trooper7652-commits/RocketFC/README.md

# RocketFC — TVC Self-Landing Model Rocket Flight Computer



Google drive link with numerous photos of this model rocket project (and a few of my other projects): https://drive.google.com/drive/folders/1t4HR8e49pa-YUd3eFnzsIMzDf4J9D1U2?usp=sharing

A complete flight computer for a thrust-vector-controlled (TVC), propulsively
landed model rocket, built for the **Teensy 4.1** with a **BMI088**
accelerometer/gyro and a **GY-63 (MS5611)** barometer.

- 2-axis servo-gimbal TVC with per-axis PID and correct roll decoupling
- Quaternion attitude estimation (gyro-integrated, accel level-init on the pad)
- 3-state Kalman filter (altitude, vertical velocity, accel bias) fusing
  barometer + accelerometer
- Full flight state machine with debounced transitions, backup timers, and
  layered aborts
- Landing-burn ignition timed by a precomputed `h_ignite(velocity)` table
  generated from the Estes F15 thrust curve
- Spring-ejected parachute on a servo latch, with accelerometer
  confirmation and automatic re-cycling of a stuck latch
- Two pyro channels with continuity sensing and multiple safety
  interlocks: landing-motor igniter, and a nichrome landing-leg release that
  burns from 1 s into a confirmed landing burn until touchdown
- 100 Hz CSV logging to the built-in microSD, USB-serial CLI, buzzer/LED
  status, EEPROM-persisted settings, hardware watchdog
- A PC replay harness that compiles the *exact* flight code and tests it
  against synthetic flights — no hardware needed

```
RocketFC.ino          hardware glue: polling scheduler (500/100/50/10 Hz)
src/config.h          every pin, gain, mass, and threshold — start here
src/core/             flight LOGIC, pure C++, shared with the PC test harness
  quat.h              vector/quaternion math
  ahrs.h              attitude estimation
  altitude_kf.h       altitude/velocity Kalman filter
  control.h           TVC PID
  flight_state.h      state machine + aborts
  chute_deploy.h      parachute release: canopy confirm + latch re-cycle
  burn_table.h        GENERATED — landing-burn ignition table
  flight_core.h       wires the above together (single entry point)
src/hw/               Teensy-only drivers: sensors, actuators, logger, CLI...
tools/
  burn_table.py       F15 thrust curve -> burn_table.h  (rerun after measuring!)
  synth_flight.py     generates synthetic test flights
  replay/             PC test harness (g++/MSYS2): make test
  plot_flight.py      post-flight log plots (matplotlib)
```

The rest of the project lives beside the firmware:

```
CAD/                  Autodesk Inventor parts (.ipt) and assemblies (.iam);
                      SpaceX Assembly.iam is the whole rocket
  exports/            STEP / STL exports
  Avionics Holder/    FEA (stress analysis) data for the avionics holder
Electronics/          KiCad schematic/PCB and the wiring diagram
ThrustStand/          HX711 static thrust stand (measures ignition delay, thrust curves)
SensorServoBenchTest/ bench rig that checks IMU axes and servo signs on real hardware
tools/sim/            closed-loop simulator + flight-log dashboard
tools/hil/            hardware-in-the-loop static-fire tooling
tools/tvc-sim/        standalone TVC PID auto-tuner
studies/              simulator design studies (landing timing, motors, parachute size)
docs/research/        research notes (other propulsive-landing projects, solver notes)
```

---

## 1. Hardware & wiring

| Signal | Teensy 4.1 pin | Notes |
|---|---|---|
| Gimbal servo A (body X torque) | 2 | PWM, 50 Hz |
| Gimbal servo B (body Y torque) | 3 | PWM, 50 Hz |
| Parachute latch servo | 23 | PWM, 50 Hz; holds the spring-ejection latch |
| Pyro fire — landing motor | 6 | MOSFET gate, low-side driver |
| Pyro fire — leg-release nichrome | 7 | MOSFET gate, low-side driver |
| Continuity sense — landing | 14 (A0) | 100k/10k divider from the landing MOSFET drain |
| Continuity sense — legs | 15 (A1) | 100k/10k divider from the legs MOSFET drain |
| Battery voltage | 16 (A2) | divider, ratio in `VBAT_DIVIDER` |
| Buzzer | 8 | active buzzer or transistor-driven |
| Arm switch | 9 | **not fitted** — pin unused, `REQUIRE_ARM_SWITCH = false` |

Power: a 2S LiPo for the flight computer and servos, and a **separate 2S
pyro LiPo** for both pyro channels. Tie the pyro LiPo's − to Teensy GND
(never the +): the MOSFET gates and the continuity dividers need the common
ground. With a load connected, each drain sits at pyro battery voltage, so
the dividers also read the pyro battery (`pyro:` in `status`).
| BMI088 + MS5611 | 18 (SDA), 19 (SCL) | I2C, 400 kHz, 3.3 V |
| LED | 13 | built-in |

Hardware rules that save rockets:

- **Teensy 4.1 is 3.3 V and NOT 5 V tolerant.** Never feed 5 V servo signals
  or sensor boards with 5 V pull-ups into its pins.
- **Servos get their own BEC/regulator**, never the Teensy's 3.3 V rail. A
  servo stall browning out the flight computer mid-burn = lost rocket.
  Common ground between BEC, battery, and Teensy.
- Parachute latch: design it so the spring **cannot back-drive the servo**
  (e.g. a pin loaded across its axis, not along it). Before the firmware
  starts, the servo gets no signal; a latch that slips when the servo goes
  limp ejects the chute on the pad. Once running, the firmware puts the
  latch back at the **last position commanded on the ground** (saved in
  EEPROM, `CHUTE_BOOT_RESTORE`), so a locked latch stays locked across a
  power-cycle. It boots **open** instead after a watchdog/crash reset, or if
  the IMU sees the vehicle moving or away from ~1 g at power-up (a power blip
  in flight). Trade-off: a power loss in flight while the rocket reads a
  steady ~1 g reboots into IDLE with the chute held in; set
  `CHUTE_BOOT_RESTORE = false` to always boot open. The servo has no memory
  of its own — unplugged it stays roughly put but doesn't hold against the
  spring. The chute servo shares
  the gimbal servos' BEC — check the rail with all three moving at once.
- Pyro channels: logic-level MOSFETs, low-side, **gate pulldown resistors**
  (so a floating pin during boot can't fire), and flyback-safe wiring.
  There is **no arm switch**: the pyro LiPo connector is the arm. The pyros
  are live whenever it is plugged in, so plug it in last, on the pad.
- Leg-release nichrome: it is on for **~3–4 s** (fire + 1 s → touchdown
  detected), drawing amps the whole time, overlapping the e-match gate by
  0.2 s and the TVC servos' hardest work. Power it from the **pyro battery**,
  never the flight computer's, through a MOSFET rated for that current.
  Touchdown is only declared after 0.8 s of stillness, so the wire keeps
  glowing ~1 s on the ground — keep it clear of anything flammable.
- Mount the IMU rigidly, close to the CG, axes square to the airframe. Set
  `IMU_R_SB` in `config.h` to match the mounting orientation.
- Barometer: open-cell foam over the MS5611 port, in a vented bay, shielded
  from sunlight (it is light-sensitive) and from ram/exhaust airflow.
- Use fast metal-gear micro servos (speed matters more than torque for TVC),
  and landing legs with some compliance — expect 1–3 m/s residual touchdown
  velocity even with perfect timing.

## 2. Toolchain setup

**Arduino IDE 2.x** (for uploading):
1. Install Arduino IDE 2.x.
2. File → Preferences → *Additional boards manager URLs*, add:
   `https://www.pjrc.com/teensy/package_teensy_index.json`
3. Boards Manager → install **Teensy**.
4. Library Manager → install **Bolder Flight Systems BMI088**.
5. Open `RocketFC.ino`, select **Teensy 4.1**, Verify/Upload.

Servo, SD/SdFat, EEPROM, and Wire ship with the Teensy core. The MS5611
driver is written in-project (`src/hw/sensors.h`) — no library needed.

**Command line** (what was used to develop this):

```
arduino-cli compile --fqbn teensy:avr:teensy41 RocketFC
```

**PC test harness** (needs g++ and Python 3):

```
cd tools/replay
make test        # regenerates synthetic flights and runs all assertions
```

## 3. Before you fly anything: measure and replace placeholders

Everything marked `[MEASURE]` in `src/config.h` is a placeholder. The
important ones:

| Parameter | How to measure |
|---|---|
| `MASS_PAD_KG`, `MASS_DESCENT_KG` | kitchen scale, fully loaded / after ascent burnout |
| `ASCENT_BURN_MS` | your ascent motor's datasheet or static test |
| `IGNITION_DELAY_MS` | **static-test the F15 igniter chain**: time from fire command to first thrust. This number directly moves the ignition altitude. |
| `CDA_M2` | estimate from a drop test or flight log velocity decay |
| Servo trims, `US_PER_GIMBAL_DEG`, signs | bench: CLI `trim`, `servotest`, direction test below |
| chute LOCK / OPEN angles | bench: CLI `chute deg <n>` until the latch is fully closed / fully open, then `chute set lock` / `chute set open` (saved in EEPROM; `CHUTE_*_DEG_DEFAULT` are only first-boot defaults) |
| `CHUTE_SERVO_US_AT_0_DEG`, `_AT_180_DEG` | servo datasheet: pulse width at 0° and 180° (default 500 / 2500 µs) |
| `CHUTE_RECYCLE_LOCK_MS` | bench: time the servo takes to swing release → lock (`chute cycle`) |
| Leg release timing | bench: `pyrotest legs`, time until the band parts; put it in the sim's "Legs: band cut" field and check the margin (see §4) |
| `VBAT_DIVIDER` | multimeter vs. `status` readout (`CONT_DIVIDER_RATIO` is set from the 100k/10k schematic; check `pyro:` against a meter) |

Then regenerate the burn table with your measured values:

```
python tools/burn_table.py     # rewrites src/core/burn_table.h
cd tools/replay && make test   # confirm the logic still passes
```

**Servo direction test (do this or the rocket flies into the ground):**
power up on the bench, run `cal`, then tilt the nose toward body +X.
The gimbal must deflect so the *thrust vector pushes the tail back under
the nose* (i.e. it fights the tilt, not amplifies it). If a channel moves
the wrong way, flip `SERVO_A_SIGN`/`SERVO_B_SIGN`. Repeat for +Y.

## 4. Flight states

```
IDLE -> ARMED -> BOOST -> COAST -> APOGEE -+-> DESCENT -> LANDING_BURN -> TOUCHDOWN
                                           |   (FULL_LANDING mode)
                                           +-> DESCENT_CHUTE -> TOUCHDOWN
                                               (CHUTE_TEST mode, or any abort)
```

- **ARMED**: gyro/level/baro calibrated, log open, launch detection live
  (>1.5 g longitudinal for 80 ms).
- **BOOST**: TVC active with boost gains. Burnout on <0.35 g for 150 ms,
  backed up by a max-burn timer.
- **COAST**: servos centered. Apogee on KF velocity ≤ 0 (200 ms), backed up
  by altitude-drop and absolute timers.
- **DESCENT**: fires the landing motor when KF altitude falls to
  `h_ignite(descent rate)` from the burn table — but only if tilt < 15°,
  the KF is healthy, and igniter continuity is present.
- **LANDING_BURN**: TVC active with landing gains. Confirms ignition by the
  accel jump; a dud igniter aborts to chute. No aborts once burning — TVC
  rides it out. `LEGS_DELAY_MS` (1 s) after the fire command — and only into
  a confirmed burn — the leg-release nichrome comes on and stays on until
  touchdown is detected (`LEGS_BURN_MAX_MS` is an independent cutoff). The
  legs never deploy in CHUTE_TEST or after an abort. **Timing is tight:** in
  the closed-loop sim the vehicle reaches the ground ~2.9 s after the fire
  command, leaving ~1.9 s for the band to part and the legs to swing down.
- **ABORT** (tilt > 30°, IMU failure, KF unhealthy, missed window, dud):
  permanently inhibits the landing motor and releases the chute (waiting for
  motor burnout if aborting during BOOST).

**Parachute release** (`src/core/chute_deploy.h`): the chute is pushed out by
a spring; the servo on pin 23 holds the latch. On release, the flight
computer watches the accelerometer for the canopy (≈0 g in freefall, ≈1 g
plus an opening spike under a canopy). If nothing shows within
`CHUTE_CONFIRM_MS` (1.5 s), it swings the latch back to LOCK for
`CHUTE_RECYCLE_LOCK_MS` and releases again — up to `CHUTE_MAX_RELEASES` in
total — then holds it open for good. Re-cycling a latch whose chute is
already out is harmless, so the detector errs on the strict side; a canopy
that opens near apogee (no airspeed yet) can show up late and cost one
needless re-cycle. Jolts below `TOUCHDOWN_ALT_M` never count, so a crash is
never logged as a good chute. Events in the log: `CHUTE_RELEASE` (every
release), `CHUTE_DETECTED`, `CHUTE_UNCONFIRMED`; the `pyro` column's bit 0 is
the latch position and the `cont` column's bit 0 is "canopy detected".
Each re-cycle costs ~2 s of fall, so on a low flight there is only time
for one or two.

**Modes** (`mode chute` / `mode land`, persisted in EEPROM):
`CHUTE_TEST` flies the full TVC ascent and pops the chute at apogee —
this is how you validate everything before risking a landing attempt.
`FULL_LANDING` attempts the propulsive landing; the chute is released only
as the abort recovery.

## 5. CLI (USB serial, 115200)

| Command | Action |
|---|---|
| `help` / `status` | command list / one-shot health & sensor readout |
| `stream` | toggle 10 Hz live telemetry |
| `cal` | gyro bias + level calibration (keep still ~4 s) |
| `zero` | baro ground reference + noise measurement |
| `arm` / `disarm` | pre-arm checks, then ARMED (launch detect live!) |
| `mode chute` / `mode land` | select flight mode (persisted) |
| `trim a +20` / `center` | servo trim (persisted) / center servos |
| `servotest` | slow gimbal sweep for the direction test |
| `circle [s] [deg]` / `circle off` | gimbal runs in circles until turned off — default 1 s/rev at full deflection; disarmed only, `center`/`stop` also end it, `cal`/`zero`/`arm` refused while circling |
| `chute` | show the parachute latch position |
| `chute open` / `chute lock` | open the latch to load the spring / lock it (arming is refused until locked) |
| `chute deg <n>` / `chute us <n>` | jog the latch servo to an angle (0–180°) or a pulse width |
| `chute set lock [deg]` / `chute set open [deg]` | save the LOCK / OPEN angle to EEPROM (default: the current jog angle); the servo only moves if it's already at that position |
| `chute defaults` | LOCK / OPEN angles back to the `config.h` defaults |
| `chute cycle` | one in-flight re-cycle: LOCK dwell, then RELEASE — tests freeing a sticky latch |
| `pyrotest land` | fire the landing e-match channel on the bench — two-step typed confirmation, disarmed only, **no motor/match connected** |
| `pyrotest legs` | burn the leg-release nichrome for 4 s (its longest in-flight burn) — two-step confirmation, disarmed only |
| `stop` | every pyro output off immediately |

## 6. Beeps & LED

| Pattern | Meaning |
|---|---|
| Boot chirp | power-on |
| Slow single blink/beep | IDLE, healthy |
| Repeating N beeps in IDLE | fault: 1=IMU 2=baro 3=SD 4=battery |
| 2 beeps repeating | ARMED, CHUTE_TEST mode |
| 3 beeps repeating | ARMED, FULL_LANDING mode |
| Silence | in flight (nothing to say, everything logged) |
| Loud repeating chirp | TOUCHDOWN — locate beacon |

## 7. Launch-day checklist

1. Fresh battery; `status` shows vbat > `VBAT_MIN`.
2. SD card inserted; `status` shows SD OK.
3. `mode` set correctly (listen for the 2-vs-3-beep pattern at arm).
4. Load the chute: `chute open` (the latch boots wherever it was last left), spring + chute
   in, `chute lock`. Strap the
   legs with a fresh band over the nichrome. Then rig motors + e-match
   **last**, on the pad, with the pyro LiPo **unplugged**.
5. Vehicle vertical on the rail, still. Plug in the pyro LiPo; `status`
   should show `pyro:` ≥ 7.0 V and continuity `landing=YES legs=YES`.
   Then `arm` from the laptop (the only way to arm). Pre-arm checks verify
   sensors, SD, battery, chute latch locked, landing e-match and legs
   nichrome continuity plus pyro battery ≥ `PYRO_VBAT_MIN` (FULL_LANDING),
   and tilt < 5°.
6. Clear the area. Launch when ready — everything from here is autonomous.
7. After recovery: `flight_NNN.csv` from the SD card →
   `python tools/plot_flight.py flight_NNN.csv` and review before any tuning.

## 8. Tuning guide

- **PID (`GAINS_BOOST`, `GAINS_LANDING`)**: start on a static test stand or
  a tethered/gimbaled mount. Raise `kp` until the response is crisp but not
  oscillating, add `kd` to damp, keep `ki` small (it exists to trim steady
  thrust misalignment). The landing gains act on a lighter vehicle —
  expect them ~30% hotter. Replay real flight logs through `tools/replay`
  to sanity-check changes before flying them.
- **Kalman filter**: `R` is measured from pad noise automatically at arm.
  `KF_SIGMA_ACCEL` is the knob: bigger = trust the baro more (noisier but
  no drift), smaller = trust the accel more (smoother but drifts).
  The logged `innov` column should look like zero-mean noise; sustained
  offsets mean the filter is mistuned.
- **Burn table margin**: after a landing attempt, compare the logged
  ignition altitude/velocity against the table's prediction and adjust
  `BURN_TABLE_MARGIN_M` (positive = ignite higher/earlier).

## 9. Reality check: what dominates landing success

The F15 is a fixed-impulse solid motor — it cannot throttle. The physics
(from `tools/burn_table.py` with a 0.95 kg descent mass):

- Only apogees roughly **15–80 m** arrive at the ignition window with an
  energy the F15 can cancel. Size the ascent motor accordingly.
- **Ascent motor: AeroTech F10** (29 mm single-use, 7 s burn, flown *plugged*,
  `tools/motors/AeroTech_F10.eng`). Its ~73 m apogee matches the F15's energy,
  and because it pushes almost all the way to apogee the fin-less airframe
  never coasts long enough to tip over in wind. The closed-loop sim study
  (2026-10-24) found short, hard-burning motors abort 94–100 % of flights.
- **±10% motor-to-motor thrust variation → ~9–15 m/s touchdown error** if
  uncompensated. This — not the software — is the hard part. Mitigate with:
  legs that absorb residual velocity, fresh motors from the same pack,
  static-tested ignition delay, and iterating on logged flights.
- ±150 ms of unmeasured ignition delay costs similar error. Measure it;
  don't guess it.

Fly the incremental program: **bench tests → static TVC stand → CHUTE_TEST
flights (validate AHRS/KF/TVC/logging) → landing attempts**, reviewing the
log after every single flight.

## 10. Safety & legal

E-matches and rocket motors are energetic devices. Never work on the pad
with the pyro battery connected; keep the pyro LiPo unplugged until the
vehicle is on the pad. Propulsive-landing TVC flights generally fall **outside**
NAR/TRA club safety codes — fly under FAA Part 101 hobby rules on private
land with generous clear distances, or coordinate explicitly with your club.
You are responsible for complying with your local regulations.

---

*Built with Claude Code. The core flight logic in `src/core/` is verified by
`tools/replay` (unit checks + 6 synthetic flight scenarios) on every change:
`cd tools/replay && make test`.*

# Why I made this project
I wanted to get my hands dirty with an advanced project so that I would force myself to learn new software and hardware skills that will be useful to me for later projects. I chose to build an autonomously landing model rocket because I was inspired by SpaceX landing their Starship. Additionally, I knew about thrust vector control in planes and fighter jets before, but I became really interested in it after I found out that they were also used in rockets as well.
