trooper7652-commits/RocketFC/studies/landing-solver-study/notes/plots/clean_apogee_sweep_all.png

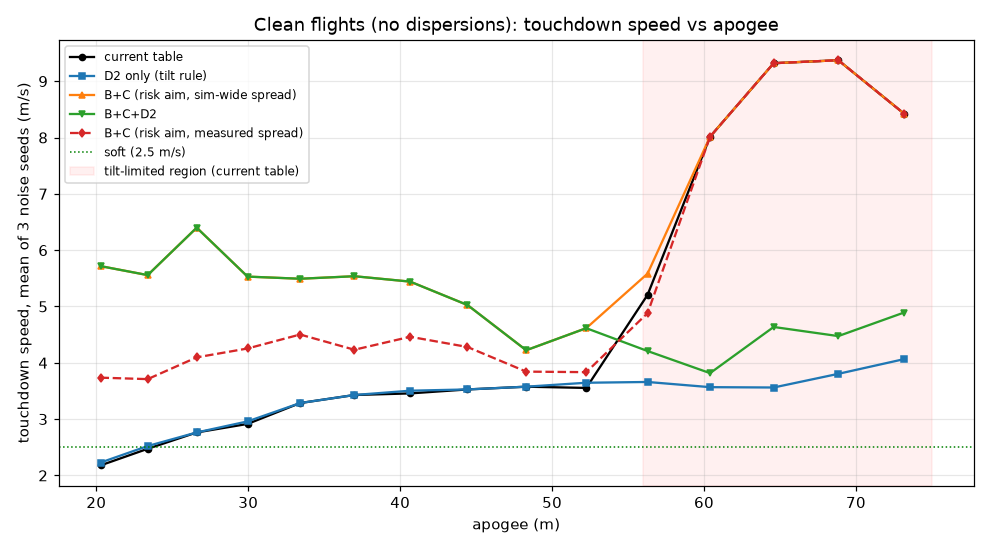
studies/landing-solver-study/notes/plots/clean_apogee_sweep_all.png
