trooper7652-commits/RocketFC/studies/landing-solver-study/notes/plots/headroom_examples.png

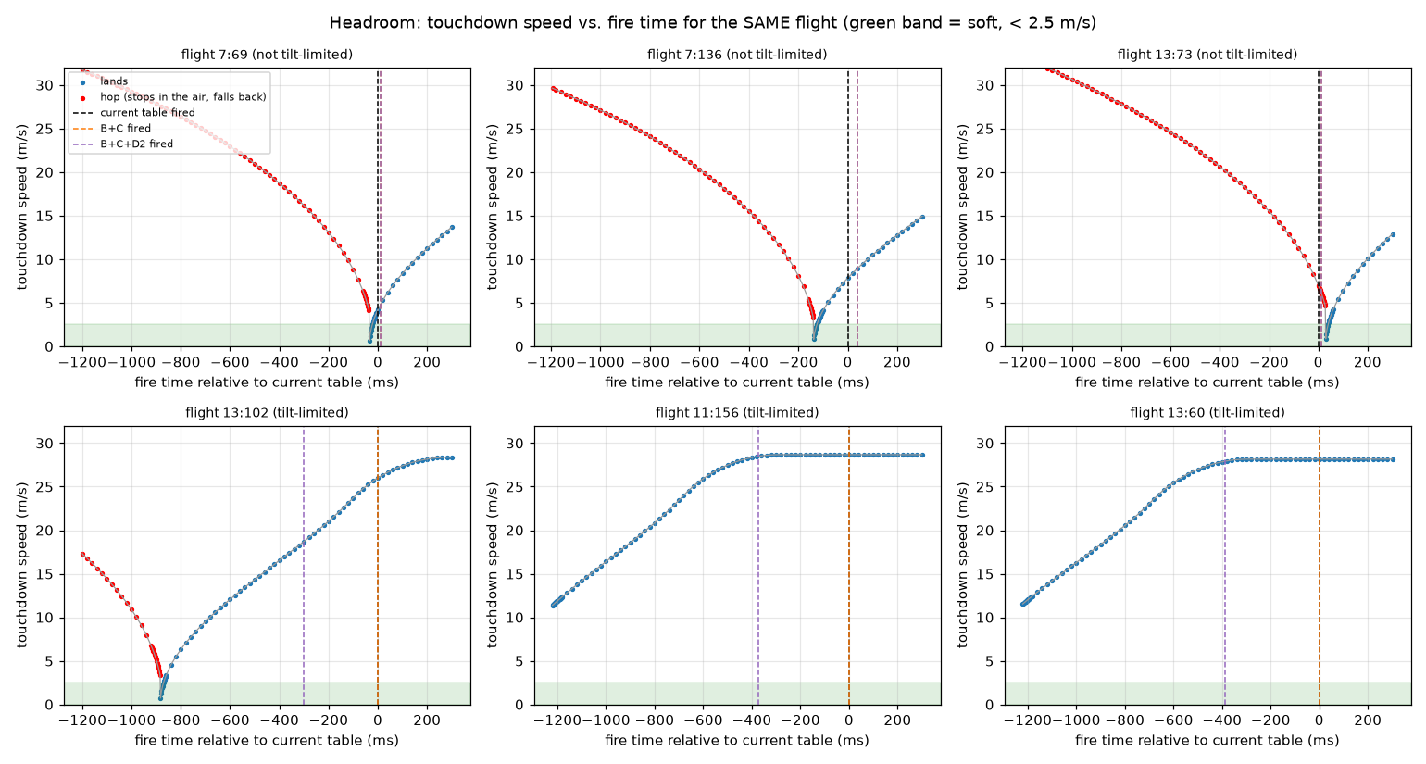
studies/landing-solver-study/notes/plots/headroom_examples.png
