trooper7652-commits/RocketFC/studies/landing-solver-study/notes/plots/holdout_cdf.png

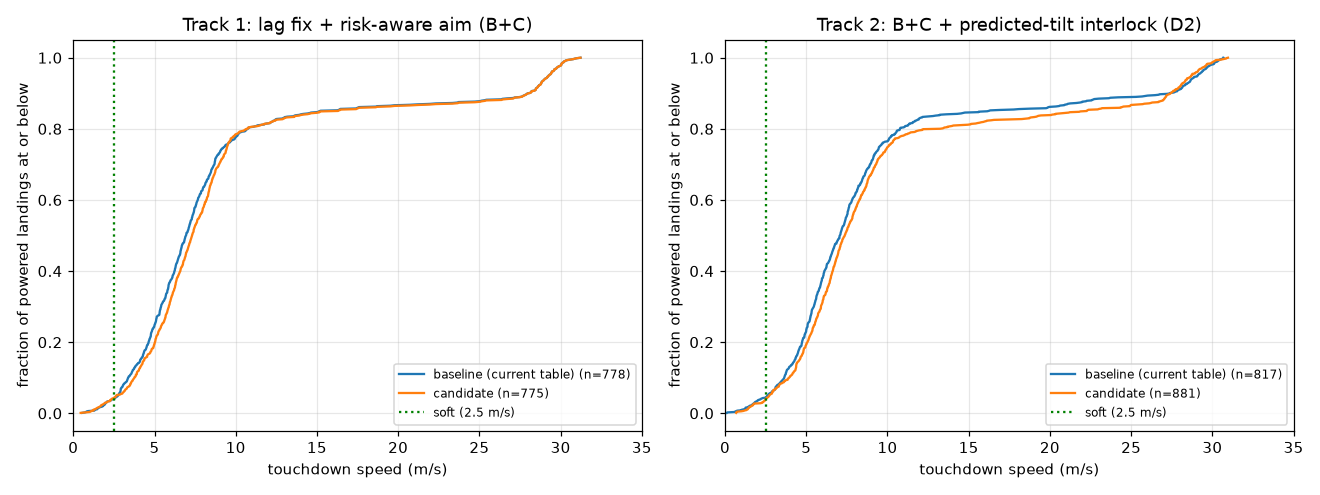
studies/landing-solver-study/notes/plots/holdout_cdf.png
