trooper7652-commits/RocketFC/studies/landing-solver-study/notes/plots/holdout_paired_scatter.png

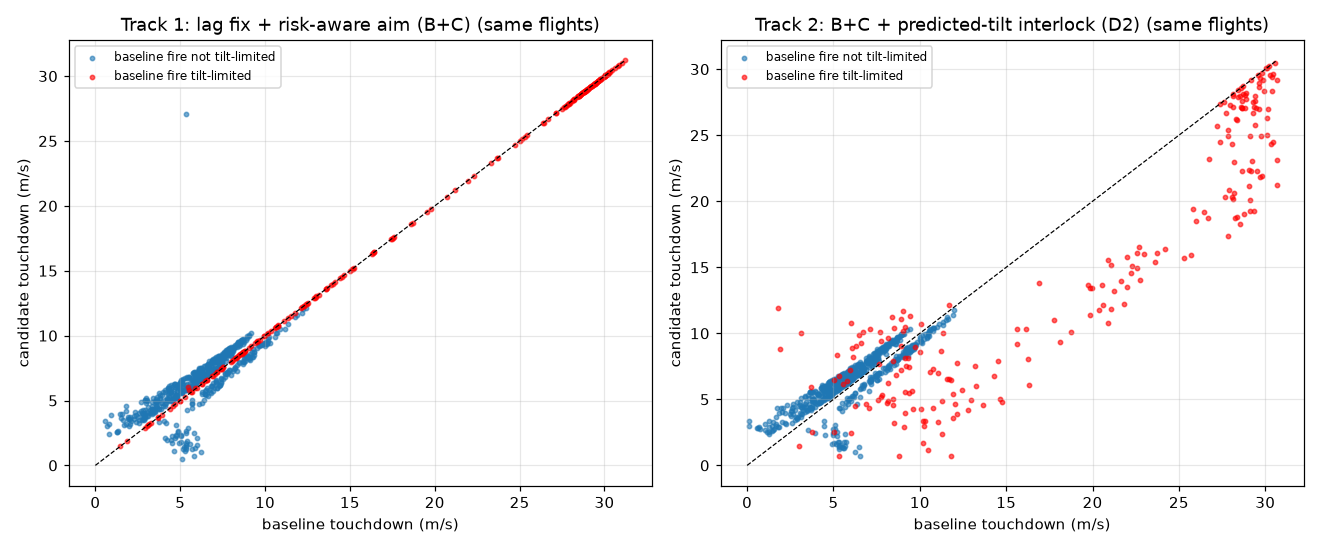
studies/landing-solver-study/notes/plots/holdout_paired_scatter.png
