trooper7652-commits/RocketFC/studies/landing-solver-study/notes/plots/p0_kf_lag_and_tilt.png

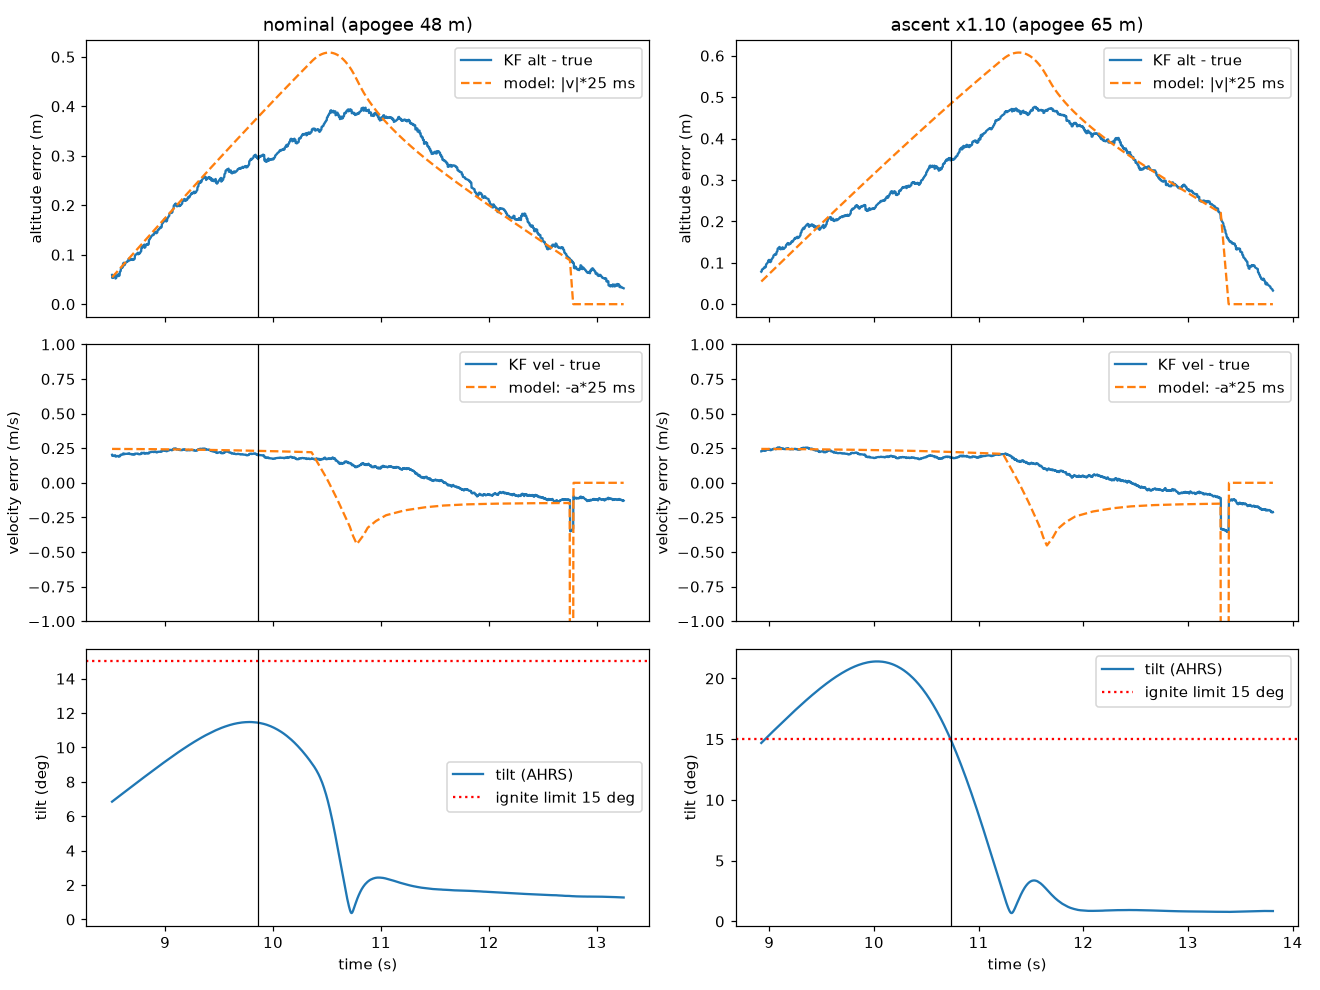
studies/landing-solver-study/notes/plots/p0_kf_lag_and_tilt.png
