trooper7652-commits/RocketFC/studies/landing-solver-study/notes/plots/value_of_information.png

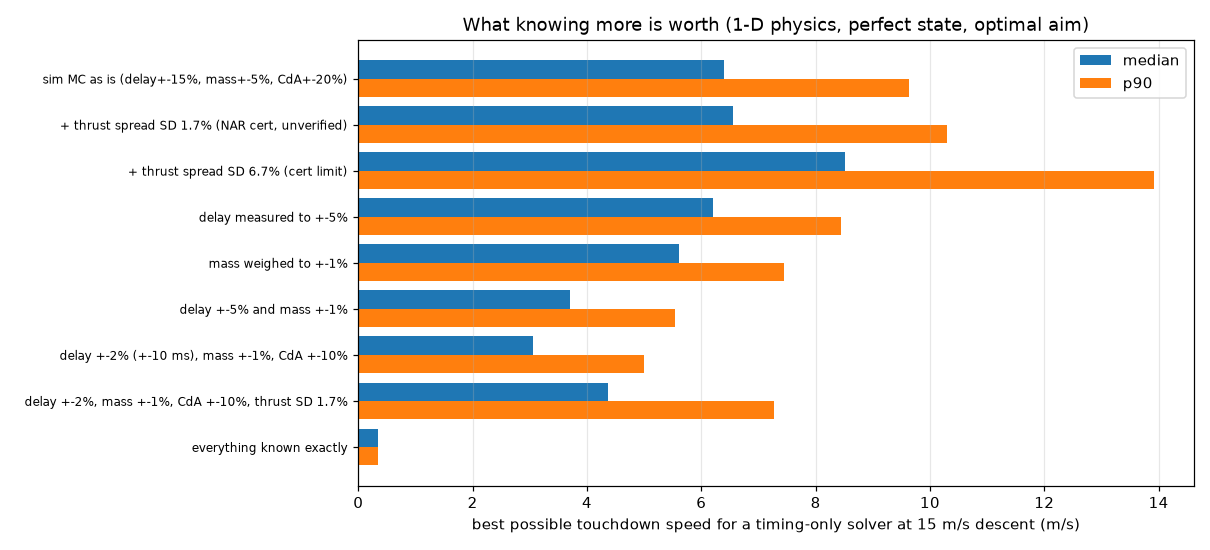
studies/landing-solver-study/notes/plots/value_of_information.png
