trooper7652-commits/RocketFC/tools/tvc-sim/gimbal.png

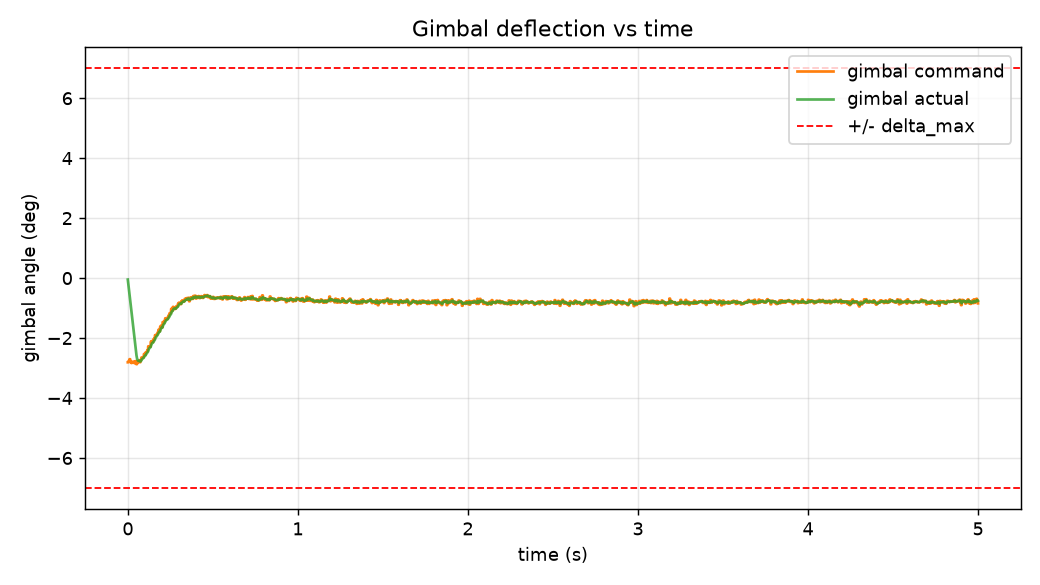
tools/tvc-sim/gimbal.png
