trooper7652-commits/RocketFC/tools/tvc-sim/rate.png

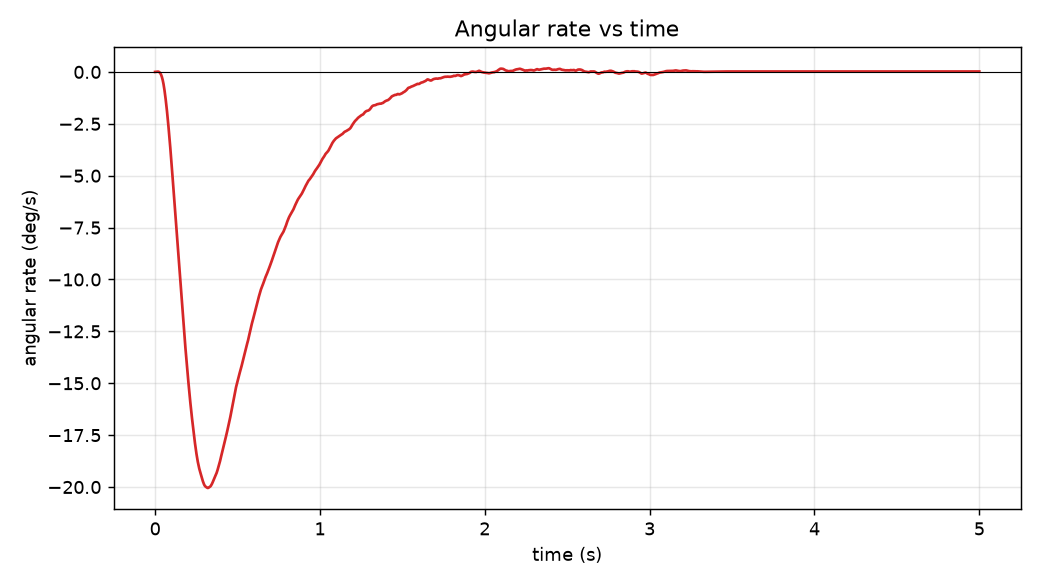
tools/tvc-sim/rate.png
