trooper7652-commits/RocketFC/tools/tvc-sim/robustness.png

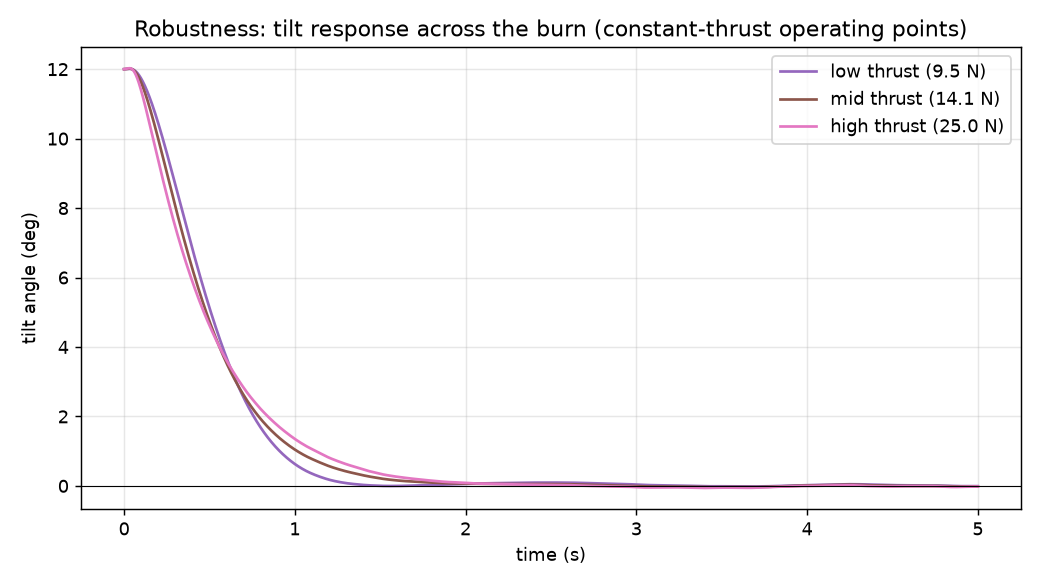
tools/tvc-sim/robustness.png
