trooper7652-commits/RocketFC/tools/tvc-sim/tilt.png

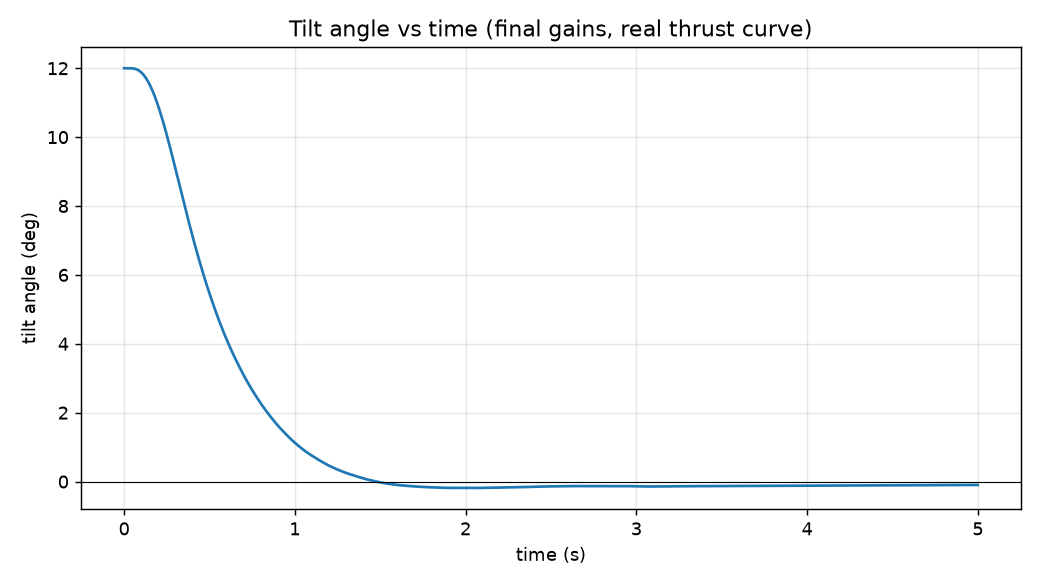
tools/tvc-sim/tilt.png
