trooper7652-commits/RocketFC/Hardware Bill of Materials - Sheet1 (1).pdf

Item Name | Qty | Price (total) (USD) | Shipping (USD) | Item link | Notes
DD4012SA DC-DC Regulator, 5V 1A | 2 | $2.29 | $0.00 https://www.aliexpress.us/item/3256806851868660.html Compact step-down regulator for powering small 5V electronics from the LiPo.
Lead-Free Solder Wire, 0.8 mm, 50 g | 1 | $7.98 | $0.00 https://www.aliexpress.us/item/3256808377261362.html Solder for assembling the flight computer perfboard and wiring harness.
Passive Buzzer, 12x8.5 mm (10 pcs) | 1 | $1.73 | $0.00 https://www.aliexpress.us/item/3256806026983317.html Piezo buzzer driven with tone() for audible arming and status alerts.
iMAX B6 80W Balance Charger (US adapter) | 1 | $41.51 | $0.00 https://www.aliexpress.us/item/3256806677465991.html Balance charger for charging and storing the 2S LiPo packs safely.
5 kg Load Cell + HX711 Module | 1 | $2.11 | $0.00 https://www.aliexpress.us/item/3256806641615421.html Sensor for the static thrust test stand that measures F15 motor thrust curves.
Soldering Tip Cleaning Ball | 1 | $1.91 | $0.00 https://www.aliexpress.us/item/3256808286810598.html Brass wool cleaner that keeps the soldering iron tip clean and tinned.
Bare Copper Wire, 0.5 mm, 10 m | 1 | $2.54 | $0.00 https://www.aliexpress.us/item/3256808892044586.html Bare wire for running traces and jumpers on the perfboard.
M5 x 30 mm Phillips Screws (10 pcs) | 1 | $2.67 | $0.00 https://www.aliexpress.us/item/2251832787469395.html M5 fasteners for assembling structural parts and test fixtures.
UL1007 22AWG Hookup Wire Kit (5 colors x 10 m) | 1 | $9.56 | $0.00 https://www.aliexpress.us/item/3256810100589680.html Color-coded stranded wire for the power, signal and pyro wiring.
SG90 9g Micro Servo, 180° (5 pcs) | 1 | $2.70 | $0.00 https://www.aliexpress.us/item/3256806385982254.html Micro servos that actuate the dual-axis TVC gimbal.
Electrolytic Capacitor Assortment (15 values, 0.1-1000 µF) | 1 | $5.35 | $0.00 https://www.aliexpress.us/item/3256809729966260.html Capacitors for decoupling and smoothing the servo and logic power rails.
Nichrome Wire, 0.2 mm | 1 | $2.55 | $0.00 https://www.aliexpress.us/item/3256805761517719.html Resistance wire for making electric motor igniters.
RC Pushrod Linkage Stoppers (20 sets) | 1 | $1.80 | $0.00 https://www.aliexpress.us/item/3256806333943831.html Adjustable connectors that link the servo arms to the TVC gimbal pushrods.
EVA Foam Strip, Self-Adhesive, 1.5 cm (2 rolls) | 1 | $1.40 | $0.00 https://www.aliexpress.us/item/3256806809954166.html Foam padding for vibration damping and snug fits around the electronics.
IRLZ44N Logic-Level MOSFET (10 pcs) | 1 | $2.40 | $0.00 https://www.aliexpress.us/item/3256804346841511.html Logic-level MOSFETs that switch the pyro channels to fire the igniters.
Brass Heat-Set Inserts, M2/M2.5/M3 (508 pcs) | 1 | $12.28 | $0.00 https://www.aliexpress.us/item/3256806116413618.html Threaded inserts melted into 3D-printed parts so they can take screws.
UBEC 5V 5A Switching BEC | 1 | $0.95 | $0.00 https://www.aliexpress.us/item/3256803510775753.html Dedicated 5V supply for the servo rail that keeps servo current spikes off the logic rail.
DC-DC 3A Buck Converter, 5V | 1 | $1.81 | $0.00 https://www.aliexpress.us/item/3256803378451942.html Buck converter that supplies the 5V logic rail for the flight computer.
Double-Sided Prototype PCB, 9x15 cm | 1 | $1.63 | $0.00 https://www.aliexpress.us/item/3256805913834017.html Perfboard that the flight computer is built on.
CMK642 Lever Wire Connectors (5 pcs) | 1 | $4.79 | $0.00 https://www.aliexpress.us/item/3256809787011836.html Lever connectors for quick, solder-free wire splices.
Tattu 2S 7.4V 450mAh 75C LiPo (2 pcs) | 1 | $18.02 | $0.00 https://www.aliexpress.us/item/3256805952710385.html 2S LiPo packs for the flight power and the separate pyro battery.
GY-63 MS5611 Barometric Pressure Sensor | 1 | $4.42 | $0.00 https://www.aliexpress.us/item/3256808617110944.html Barometer for altitude estimation, sharing the I2C bus with the IMU.
MagicWater Mailing Tube, 3 in x 12 in, White (6 pack) | 1 | $26.89 | $0.00 https://magicwatersupply.com | Cardboard tubes for the rocket body sections.
BMI088 Gyroscope Accelerometer | 1 | $11.10 | $0.00 https://www.alibaba.com/product-detail/BMI088-Gyroscope-Accelerometer-Six-Axis-Sensor_1601761750328.html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 6 axis IMU for measuring acceleration and orientation
TEENSY 4.1 WITHOUT ETHERNET | 1 | $33.60 | $4.99 https://www.digikey.com/en/products/detail/sparkfun-electronics/20360/16688096 Computer used to compute operations of rocket
Estes F15-0 engines | 6 | $33.99 | $0.00 https://b2b.estesrockets.com/products/f15-0-enginesAscent and descent motor on rocket
Black PETG filament for 3D prints | 1 | $18.59 | $6.99 https://www.amazon.com/Official-Creality-Filament-30-600mm-Stringing/dp/B0D923Q2BS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 Filament used for 3D printed parts
Rubber bands | 1 | $7.19 | $6.99 https://www.amazon.com/AmazonBasics-Assorted-Color-Rubber-Bands/dp/B074B1KCXD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 Rubber bands used to pull legs struts down and hold legs together at top
128GB microSD card | 1 | $35.14 | $0.00 https://www.amazon.com/dp/B08TJRVWV1?ref=ppx_yo2ov_dt_b_fed_asin_title microSD card used to log data from sensors using the flight computer
Respirator mask | 1 | $51.39 | $0.00 https://www.amazon.com/dp/B01H0S90QE?ref=ppx_yo2ov_dt_b_fed_asin_title Respirator used to protect lungs during testes with the rocket motors where the smoke produced can be harmful
RMRC Carbon Fiber Tube, 5 mm x 3.5 mm, 1 m | 8 | $28.88 | $8.33 https://www.readymaderc.com/products/details/carbon-fiber-tube-5mm-x-3-5mm-1m-long Lightweight, stiff carbon tube for structural members, cut to length from 1 m sections.
Total Price (USD): | $406.47
