trooper7652-commits/RocketFC/CAD/exports/SpaceX Assembly_V2.stp

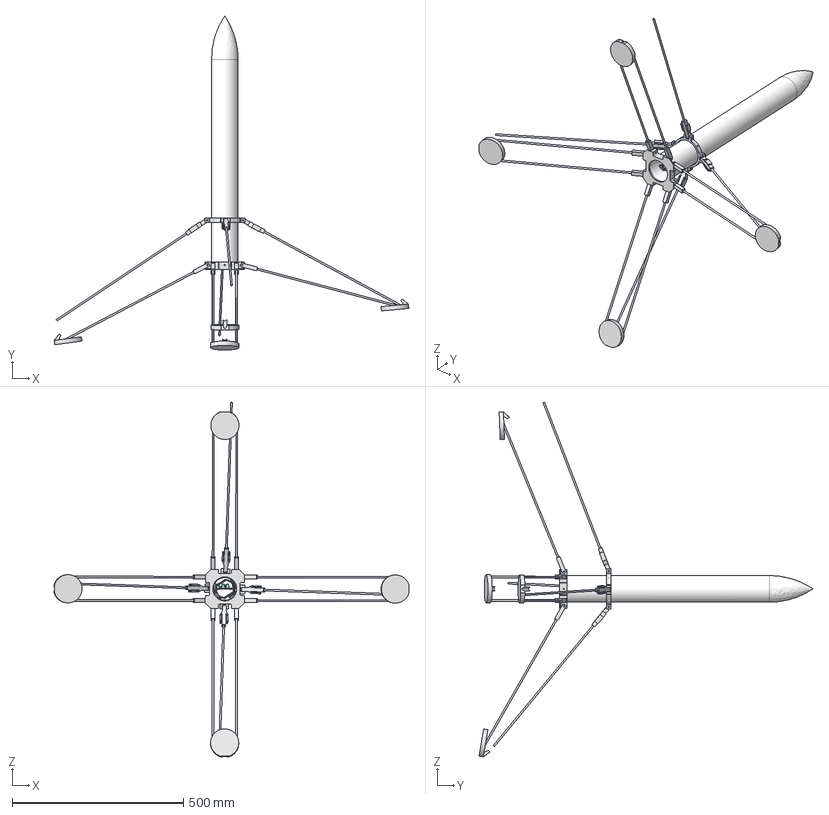
[picture p18: CAD file, 2026-11-06]
CAD/exports/SpaceX Assembly_V2.stp
1037.3 x 976.6 x 1037.2 mm
Outer GImbal
Inner GImbal
Upper leg x 4
Upper leg connector to UL Ring_4 x 4
Lower leg to lower G connector_8 x 8
Lower leg_8 x 8
Landing Leg pad_4 x 4
Upper leg ring_1
Lower leg ring
TO-220-3_Vertical_1 x 2
R_Axial_DIN0204_L36mm_D16mm_P508mm_Horizontal x 8
TerminalBlock_Phoenix_MKDS-1,5-3-5.08_1x03_P5.08mm_Horizontal_1 x 3
Converter_DCDC_XP_POWER_IA48xxD_THT
Converter_DCDC_TRACO_TSR_1_THT
CP_Radial_D80mm_P350mm
LGA_8_3x5mm_P125mm
Bosch_LGA-16_4.5x3mm_P0.5mm_LayoutBorder7x1y_ClockwisePinNumbering_1
RocA664_PCB
Avionics Holder
