trooper7652-commits/RocketFC/CAD/exports/Parachute Bulkhead piston V3.stl

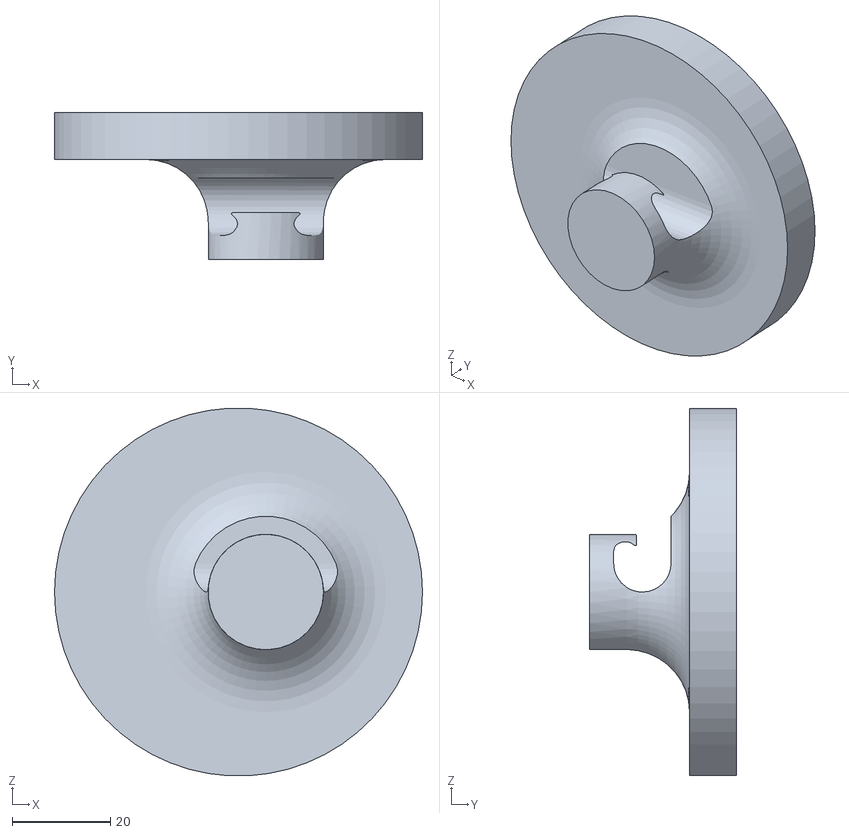
[picture p19: CAD file, 2026-11-06]
CAD/exports/Parachute Bulkhead piston V3.stl
74.9 x 29.8 x 74.8
