trooper7652-commits/RocketFC/CAD/exports/Parachute Bulkhead_V3.stl

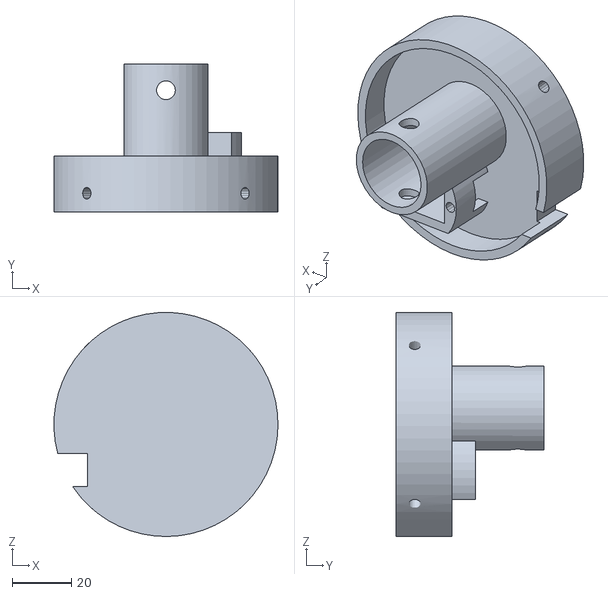
[picture p20: CAD file, 2026-11-06]
CAD/exports/Parachute Bulkhead_V3.stl
75.9 x 50.2 x 75.9
