trooper7652-commits/RocketFC/(list of files, cad)

Other CAD files:
CAD/Lower leg ring_1 V2.ipt
CAD/Lower leg to lower G connector_8.ipt
CAD/Nose Cone.ipt
CAD/Parachute Bulkhead piston V4.ipt
CAD/Parachute Bulkhead_V4.ipt
CAD/Parachute ejection.iam
CAD/Rack and Pinion.iam
CAD/Servo Wheel.ipt
CAD/Servo gear pin.ipt
CAD/SpaceX Assembly.iam
CAD/Upper leg connector to UL Ring_4.ipt
CAD/parchute servo assembly.iam
CAD/pin.ipt
