trooper7652-commits/RocketFC/Rocket electronics.kicad_sch

## KiCad design Rocket electronics.kicad_sch (2026-11-06)

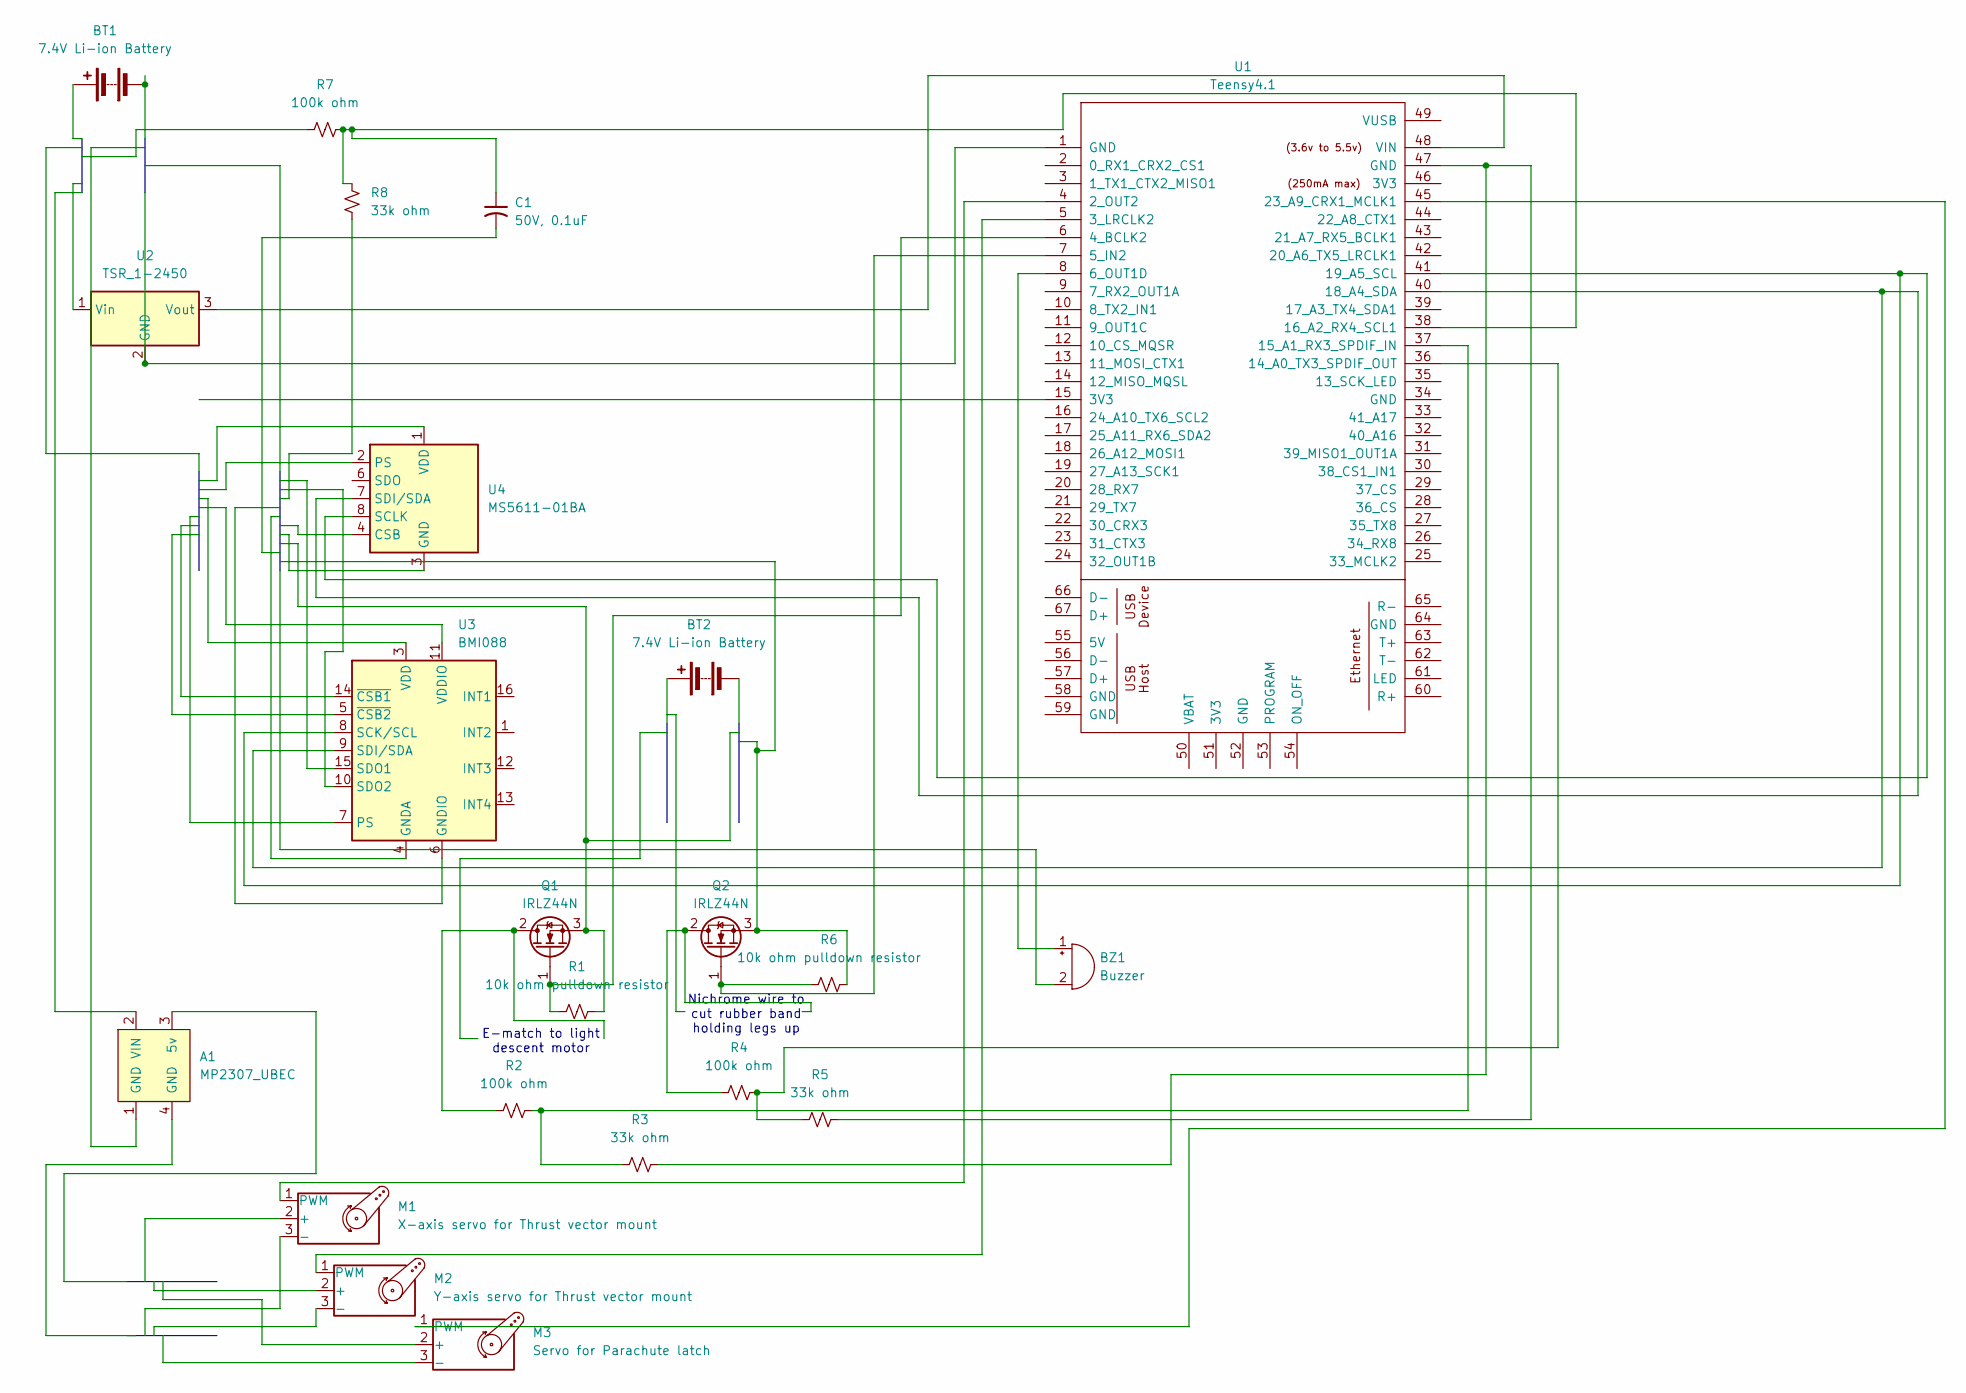
[picture p21: schematic Rocket electronics.kicad_sch]

Parts:
A1: MP2307_UBEC
BT1, BT2: 7.4V Li-ion Battery
BZ1: Buzzer
C1: 50V, 0.1uF
M1: X-axis servo for Thrust vector mount
M2: Y-axis servo for Thrust vector mount
M3: Servo for Parachute latch
Q1, Q2: IRLZ44N; TO-220-3_Vertical
R1, R6: 10k ohm pulldown resistor
R2, R4, R7: 100k ohm
R3, R5, R8: 33k ohm
U1: Teensy4.1
U2: TSR_1-2450; Converter_DCDC_TRACO_TSR-1_THT
U3: BMI088; Bosch_LGA-16_4.5x3mm_P0.5mm_LayoutBorder7x1y_ClockwisePinNu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
U4: MS5611-01BA; LGA-8_3x5mm_P1.25mm

Connections:
unnamed: BZ1.1 (+), U1.8 (6_OUT1D)
unnamed: C1.1, R7.2, R8.1, U1.38 (16_A2_RX4_SCL1)
unnamed: M1.1 (PWM), U1.4 (2_OUT2)
unnamed: M2.1 (PWM), U1.5 (3_LRCLK2)
unnamed: M3.1 (PWM), U1.45 (23_A9_CRX1_MCLK1)
unnamed: Q1.1 (G), R1.1, U1.6 (4_BCLK2)
unnamed: Q1.2 (D), R2.1
unnamed: Q1.3 (S), R1.2
unnamed: Q2.1 (G), R6.1, U1.7 (5_IN2)
unnamed: Q2.2 (D), R4.1
unnamed: Q2.3 (S), R6.2
unnamed: R2.2, R3.1, U1.37 (15_A1_RX3_SPDIF_IN)
unnamed: R3.2, R5.2, U1.47 (GND)
unnamed: R4.2, R5.1, U1.36 (14_A0_TX3_SPDIF_OUT)
unnamed: U1.1 (GND), U2.2 (GND)
unnamed: U1.40 (18_A4_SDA), U3.9 (SDI/SDA), U4.7 (SDI/SDA)
unnamed: U1.41 (19_A5_SCL), U3.8 (SCK/SCL), U4.8 (SCLK)
unnamed: U1.48 (VIN), U2.3 (Vout)
unnamed: U3.2 (GNDA), U3.4 (GNDA)
unnamed: U4.4 (CSB), U4.5 (CSB)

Notes on the sheet:
Nichrome wire to cut rubber band holding legs up
E-match to light descent motor
