trooper7652-commits/RocketFC/(commit log)

2026-07-03 RocketFC: TVC self-landing flight computer for Teensy 4.1
    Complete flight computer for a thrust-vector-controlled, propulsively
    landed model rocket (Teensy 4.1 + BMI088 + MS5611):
    - Quaternion AHRS (gyro-integrated, accel level-init on the pad)
    - 3-state Kalman filter (alt / velocity / accel bias), pad-measured R,
    innovation gating with forced-accept recovery
    - 2-axis PID TVC with body-frame roll decoupling, dual gain sets
    - Debounced flight state machine with backup timers and layered aborts
    (tilt, IMU fail, KF unhealthy, missed window, dud igniter)
    - Landing-burn ignition from a generated h_ignite(v) table built from
    the Estes F15 thrust curve (tools/burn_table.py)
    - Non-blocking MS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
    [RocketFC.ino, actuators.h, ahrs.h, altitude_kf.h, burn_table.py, cli.h, config.h]
2026-09-21 Update IMU mount matrix, VBAT divider from bench measurements
    Measured on the bench 2026-08-16 with SensorServoBenchTest:
    - IMU_R_SB: nose-up gravity lands on sensor -X; matrix maps that onto
    body +Z with a right-handed completion. Lateral axis assignment
    (servo A vs B) still needs the gimbal direction test to confirm.
    - VBAT_DIVIDER: 4.03 -> 6.0 (10k:2k divider as built).
    Also regenerates the burn_table.h date stamp, and extends .gitignore
    to cover stray build artifacts (tools/replay/main.exe, src/core/*.exe)
    and the upcoming tools/sim build cache.
    [config.h, quat.h]
2026-09-21 Add ThrustStand: static thrust test stand for motor characterization
    Arduino Uno/Nano + HX711 load cell + IR remote + 16x2 LCD static-fire
    stand. Measures peak thrust, total impulse, burn time, NAR class, and
    the ignition delay RocketFC's config.h needs (IGNITION_DELAY_MS).
    Exports feed back into the main flight computer:
    - tools/eng_export.py produces a RASP .eng file for tools/burn_table.py
    - tools/plot_thrust.py prints the ignition-delay line to paste into
    ../src/config.h
    [ThrustStand.ino, cal_store.h, config.h, eng_export.py, igniter.h, ir_input.h, load_cell.h, plot_thrust.py]
2026-09-21 Add 3D flight view and stage-labelled scrubber
    The dashboard's vehicle panel was a flat matplotlib line segment on a 2D
    axis -- accurate, but it read nothing like flying a rocket and couldn't be
    rotated. SensorServoBenchTest/viz already had a real pygame/OpenGL renderer
    built for this exact vehicle; it just never flew, because a bench rig
    doesn't translate.
    - tools/sim/viz3d/: quatmath/scene/model vendored from the bench viz with
    provenance banners (copied rather than imported across projects so
    RocketFC stays clonable on its own -- the same reasoning, reversed, as
    SensorServoBenchTest/sync_core.py). scene.py gains a moving origin, a
    metre-scaled grid that follows the vehicle, an al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
    [dashboard.py, flight3d.py, logfile.py, model.py, quatmath.py, scene.py]
2026-09-21 3D view: 1.8x frame rate, gimbal crosshair, landing velocity, KF ghost
    Frame rate was capped by our own code, not by the renderer. Measured
    before/after on a 300-frame playback loop at 1100x720:
    playback 183 FPS (5.46 ms) -> 302 FPS (3.32 ms)
    paused -> 985 FPS (1.01 ms)
    ...while also ADDING the ghost, the coloured trail and the crosshair. What
    was actually costing the time:
    - The trail drew every sample -- ~6600 immediate-mode vertices per frame,
    each glVertex3f a Python call. Decimated to ~400 points (stage boundaries
    force-kept so colour changes don't land on the wrong segment); visually
    identical for a smooth trajectory.
    - The overlay rebuilt A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
    [dashboard.py, flight3d.py, scene.py]
2026-09-21 Fix the real 3D frame rate: 17 -> 57 FPS (it was the matplotlib redraw)
    The previous commit claimed 302 FPS and the user still saw 12-13. Both
    numbers were real; mine was measured on a path nobody runs -- view.pump()/
    view.render() in a bare Python loop, no Tk, no dashboard. Measured properly
    on the integrated app (dashboard + 3D window + playback, 6626-row flight):
    before after
    3D FPS (HUD) 17 57
    cursor update 95.3 ms 4.5 ms
    full Dashboard.redraw 140 ms n/a (gone)
    The renderer was never the bottleneck -- pumped through Tk with no
    matplotlib work it already managed 188 FPS. Dashboard.redraw() re-plotted
    ~11 series of 6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
    [dashboard.py]
2026-09-21 Add a double-click launcher for the simulator
    Saves typing the path to tools\sim every time. Picks the py launcher over
    bare "python", which on this machine can resolve to the Microsoft Store
    stub -- that one has no matplotlib and fails with a confusing error rather
    than a useful one. Keeps the console open on failure with the pip line
    needed to fix a missing package.
    Finds the simulator relative to itself and works from either the repo root
    or one directory above it, so the copy that sits beside the CAD files in
    the project folder is byte-identical to this one instead of being a
    near-duplicate that drifts.
    The simulator itself is deliberately NOT moved: bridge.cpp includes
    "..\..\src\core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
2026-10-04 Spring/servo parachute with confirm + re-cycle; nichrome leg release
    Two hardware changes, landed together because they share the pyro layer.
    Parachute: one chute, pushed out by a spring and released by a servo latch
    on pin 23. The chute e-match channel is gone (pin 6 and 14/A0 freed). WHEN
    to deploy is unchanged (apogee in CHUTE_TEST, any abort in either mode,
    waiting for burnout if aborting in BOOST). What is new is checking that it
    worked, in src/core/chute_deploy.h (pure C++, tested on PC):
    - After each release, look for the canopy in |specific force| (~0 g in
    freefall, ~1 g plus an opening spike under a canopy), measured against a
    baseline taken at that release -- drag on a fast p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
    [RocketFC.ino, actuators.h, bridge.cpp, chute_deploy.h, cli.h, config.h, core.py, dashboard.py]
2026-10-09 Match pyro config to the real wiring: 100k/33k continuity, pyro battery check, no arm switch
    - CONT_DIVIDER_RATIO = 4.03 for the 100k/33k drain-to-pin dividers on
    pins 14/15, so continuity volts are real drain volts.
    - The dividers also read the separate 2S pyro LiPo: `status` prints
    `pyro:` and FULL_LANDING arm refuses below PYRO_VBAT_MIN (7.0 V).
    - No arm switch is fitted: REQUIRE_ARM_SWITCH stays false, `status` no
    longer prints the floating pin 9, and the README treats plugging in
    the pyro LiPo as the arm (rig with it unplugged, plug in on the pad,
    `status`, then `arm`).
2026-10-09 Fix continuity divider: 100k/10k (ratio 11.0), not 100k/33k
    The bottom resistor on pins 14/15 is 10k. Pin sees ~0.76 V at a full
    2S (8.4 V), well inside 3.3 V.
    [config.h]
2026-10-09 Swap pyro pin assignments to match the wiring
    Landing motor: gate 6, continuity 14. Legs nichrome: gate 7, continuity 15.
    All code uses the PIN_* names, so only config.h and the README table change.
    [config.h]
2026-10-17 Chute latch boots open; add `circle` gimbal CLI command
    - The chute latch servo now starts at RELEASE (interrupts off across
    attach + write), so the spring + chute can be loaded right after power-up;
    `chute lock` locks it and arming stays refused until locked. A reboot with
    a loaded spring therefore ejects the chute (README updated).
    - CHUTE_LOCK_US / CHUTE_RELEASE_US set to 1500 / 1000 us (still [MEASURE]).
    - New CLI `circle [s] [deg]` / `circle off`: runs the gimbal in circles for
    bench checks (disarmed only; `center`/`stop` also end it; cal/zero/arm
    refused while circling).
2026-10-17 Simulator: legs/ground model, landing verdict, success-rate report, 3D landing view
    - ground.py: legs-and-grass contact physics after touchdown (4 feet, tail
    ring, body points, friction, random field slope, wind on the standing
    body). The rocket can now bounce, be lifted back off by a still-burning
    F15, or fall over. VehicleConfig.ground_model "legs" (default); "arrest"
    keeps the old 12 g stop and is bit-identical to earlier runs.
    - landing_outcome.py: per-flight verdict (SUCCESS or the first failure:
    no powered landing, hop, legs not down, legs broken, lifted off, tipped
    over, blown over) plus what pushed it over, compared with tip limits.
    - landing_report.py: Monte Carlo succes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
2026-10-25 Fix MS5611 driver never reading pressure
    tempDue() is true while cycle_ % BARO_TEMP_EVERY == 0, but cycle_ only
    advanced after a D1 (pressure) read and starts at 0, so the driver looped
    on D2 (temperature) forever: zero/arm timed out and the altitude KF never
    got baro. Count the D2 read too. Present since the first commit; found
    while building the HIL static-fire tooling.
2026-10-25 Simulator: hold the rocket on the pad, apply the normal force as a force
    Two plant flaws found in the 2026-10-19 landing study, both now on by
    default (VehicleConfig.pad_hold, normal_force_translates):
    - The fin-less rocket could rotate freely on the pad and tip in wind
    before launch; the pad gyro calibration absorbed that as bias, leaving
    2-7 deg of attitude error by landing.
    - The aero normal force only produced torque; it now also pushes the CG,
    so the accelerometer feels crosswind.
    Earlier study reports carry a dated caveat.
2026-10-25 Add HIL static-fire ground-test tooling
    tools/hil plays a simulated flight's sensor inputs to the real Teensy in
    real time (second USB serial port) while both motors fire on a stand, logs
    the real IMU to measure the landing-motor ignition delay, and compares the
    run against the PC reference. The HIL firmware is a generated copy of src/
    with only sensors.h swapped (make_hil.py). test_hil.py runs the whole chain
    on the PC against mocks.
    run.py gains an off-by-default record_inputs option (result-neutral) that
    captures the CoreInputs the traces are built from. Generated traces and
    session logs are git-ignored.
2026-10-25 Landing burn: drift cancelling, fire 1 m higher, NaN guard; F10 curve
    - S3 drift cancelling (DRIFT_GAIN 2.0, DRIFT_MAX_TILT_DEG 5): during the
    landing burn, lean the TVC target against the sideways velocity
    dead-reckoned from launch, so the rocket stops drifting before touchdown.
    - BURN_TABLE_MARGIN_M 0 -> 1.0: ignite 1 m higher.
    - flight_state.h: reject a NaN fall speed before burntable::hIgnite(),
    which casts it to int (undefined behaviour).
    - tools/motors/AeroTech_F10.eng: recommended ascent motor (29 mm, 7 s burn,
    no L1 needed), certified curve from the OpenRocket motor database. The
    firmware's motor constants still describe the F15 ascent.
    Closed-loop sim holdout (seeds 701-7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
2026-10-25 Simulator: canopy drag acts along the relative wind
    The parachute's drag was applied along the rocket's body axis only, so a
    rocket hanging or swinging sideways under the canopy lost most of its chute
    drag. A calm CHUTE_TEST descent sped up from ~5.8 to 12.5 m/s in the last
    ~10 m; aborted flights hit at 9-14 m/s instead of ~5.8 m/s. The canopy drag
    now opposes the relative wind whatever the attitude.
    Switch VehicleConfig.chute_drag_along_wind (default True; False = old
    model). Powered landings never deploy the chute and are bit-identical
    (60/60 flights, seed 7). Earlier chute-recovery impact speeds were too high.
2026-10-25 Ascent motor AeroTech F10; measured 620 ms ignition delay
    - config.h: IGNITION_DELAY_MS 500 -> 620 (measured on the static test).
    F10 ascent: ASCENT_BURN_MS 3500 -> 7050, MASS_PAD_KG 1.10 -> 0.991,
    MASS_DESCENT_KG 0.95 -> 0.951 (the F15 ascent casing swapped for the F10's;
    masses still [MEASURE]). burn_table.h regenerated (F15 curve, 0.951 kg,
    620 ms).
    - burn_table.py: --mass/--cda/--delay-ms default to src/config.h via
    config_value(); synth_flight.py reads the same values instead of its own
    copies and flies the F10 ascent.
    - tools/sim/vehicle.py: ASCENT_ENG (F10) is the default ascent motor; the
    defaults that mirror config.h follow it.
    - Replay: dud_igniter now expects the can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
2026-10-25 Simulator: measured 28 in foot radius; report tip limits from the geometry
    - vehicle.py: leg_foot_radius_m 0.25 (estimate) -> 0.711 m, the user's
    measurement (28 in, centreline to foot pad). The sideways tip-over limit
    rises from ~0.85-1.2 m/s to ~2.7-3.9 m/s (static tip angle 16 -> 40 deg).
    viz3d LegGeom's default follows.
    - landing_report.py: the tip-limit sentence and the sensitivity defaults are
    computed from the flights' own geometry instead of hard-coded 0.25 m text;
    the 0.15/0.35 m foot-radius what-ifs are dropped now that it's measured.
    - test_landing_outcome.py: the ground-model physics checks use a fixed 0.25 m
    reference stance, so they test the model rather than the re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
2026-10-27 Rename Avionics Holder.ipt to CAD/Avionics Holder.ipt
2026-10-27 Rename Inner GImbal.ipt to Cad/Inner GImbal.ipt
2026-10-27 Rename Landing Leg pad_4.ipt to CAD/Landing Leg pad_4.ipt
2026-10-27 Rename Lower leg ring_1 V2.ipt to CAD/Lower leg ring_1 V2.ipt
2026-10-27 Rename Lower leg to lower G connector_8.ipt to CAD/Lower leg to lower G connector_8.ipt
2026-10-27 Rename Lower leg_8.ipt to CAD/Lower leg_8.ipt
2026-10-27 Rename Motor Coupler_1.ipt to CAD/Motor Coupler_1.ipt
2026-10-27 Rename Motor tube 29mm.ipt to CAD/Motor tube 29mm.ipt
2026-10-27 Rename Nose Cone.ipt to CAD/Nose Cone.ipt
2026-10-27 Rename Outer GImbal.ipt to CAD/Outer GImbal.ipt
2026-10-27 Rename Parachute Bulkhead piston V4.ipt to CAD/Parachute Bulkhead piston V4.ipt
2026-10-27 Rename Parachute Bulkhead_V2_1.ipt to CAD/Parachute Bulkhead_V2_1.ipt
2026-10-27 Rename Parachute Bulkhead_V3.ipt to CAD/Parachute Bulkhead_V3.ipt
2026-10-27 Rename Parachute bulkhead_1.ipt to CAD/Parachute bulkhead_1.ipt
2026-10-27 Rename Rack and Pinion.iam to CAD/Rack and Pinion.iam
2026-10-27 Rename Servo Wheel.ipt to CAD/Servo Wheel.ipt
2026-10-27 Rename Servo gear pin.ipt to CAD/Servo gear pin.ipt
2026-10-27 Rename SpaceX Assembly.iam to CAD/SpaceX Assembly.iam
2026-10-27 Rename Spring parachute mechanism.iam to CAD/Spring parachute mechanism.iam
2026-10-27 Rename Upper leg connector to UL Ring_4.ipt to CAD/Upper leg connector to UL Ring_4.ipt
2026-10-27 Rename Upper leg ring_1 V2.ipt to CAD/Upper leg ring_1 V2.ipt
2026-10-27 Rename Upper leg.ipt to CAD/Upper leg.ipt
2026-10-27 Rename SpaceX Assembly.stp to CAD/SpaceX Assembly.stp
2026-10-28 Rename Screenshot 2026-10-27 205933.png to Wiring Diagram
2026-10-28 Rename Wiring Diagram to Electronics/Wiring Diagram
2026-11-06 Chute servo in degrees with saved angles and boot restore; ASCII burn table
    - The chute latch LOCK/OPEN positions are angles saved in EEPROM
    (ConfigStore v2; a v1 record is migrated, keeping the mode, trims and
    flight counter). New CLI: chute deg <n>, chute set lock|open [deg],
    chute defaults. Degrees map to pulses via CHUTE_SERVO_US_AT_0/180_DEG.
    - The latch powers up at its last ground-commanded position
    (CHUTE_BOOT_RESTORE), except after a watchdog/crash reset or when the
    IMU shows the vehicle moving or away from 1 g at power-up (opens).
    After touchdown the open latch is saved, so a power cycle keeps it open.
    - burn_table.py writes an ASCII header and reads .eng files as UTF-8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
2026-11-06 Add CAD updates, design studies, research notes, bench test and PID tuner
    Organized from the SpaceX Rocket project folder; files already in the repo
    are not re-added.
    - CAD/: new Parachute Bulkhead_V4, Parachute ejection and parachute servo
    assemblies, SpaceX Assembly.iam (whole rocket) back in, current Nose
    Cone, Parachute Bulkhead piston V4 and Servo gear pin; exports/ holds the
    STEP/STL exports (SpaceX Assembly_V2.stp moved there); Avionics Holder
    FEA data.
    - studies/: the seven simulator design studies (scripts, reports, logs,
    plots, patches). Raw result dumps (357 MB) stay out of the repo; see
    studies/README.md.
    - docs/research/: other propulsive-landing projects, burn-solve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
2026-11-07 Chute servo: OPEN/SET/LOCK positions, stow to SET after release
    Three saved latch angles (OPEN 180, SET 120 for loading on the ground, LOCK 40), EEPROM v3 with v1/v2 migration, boot restore of LOCK/SET with the in-air guard. After any release the servo returns to SET at touchdown or 7 s after the first release, whichever comes first. CLI: chute open/set/lock, chute save lock|set|open [deg], chute defaults.
2026-11-07 WIP closed-loop HIL bench sim + casing-eject port (handed to cloud)
    HIL LIVE mode (sensors_hil.h): the Teensy streams 80-byte telemetry each 500 Hz tick and flies sensor frames from the PC plant; pyro hooks keep the landing gate undriven and the leg nichrome opt-in. make_hil.py --profile e18w_1400g, PC real-time host (host_live.cpp over TCP), tools/hil/live (link, scenario, flight model, runner, twin compare), live_run.py CLI. Casing-eject model ported into tools/sim and burn_table.py (off by default), core.build_from_src, mc_batch --dll, E18W motor file. See tools/hil/live/HANDOFF.md for status and the remaining tasks.
2026-11-07 HIL live: Linux build of the PC host, readable twin outcome row
    mock SD.h: POSIX mkdir takes a mode (Windows path unchanged). Twin table
    prints long text values (landing outcome) on their own lines.
    Re-ran chute and land against host_live: event names match, chute touchdown
    2.55 m/s, land mode 2.39 m/s, twin identical, landing gate never driven.
2026-11-07 HIL live: test_live.py PC test; wait for the TOUCHDOWN event before ending
    test_live.py builds host_live from the e18w_1400g profile build and flies 8
    cases (chute, land, dud, stuck chute, IMU dropout, frozen IMU, operator
    abort, live legs) each against a fresh host on its own ports. Every case:
    twin agrees and the landing gate is never driven. Prints link statistics.
    Uses MSYS2 g++ when present, else g++ on PATH; -lws2_32 on Windows only.
    Runner: end a flight 1 s after the Teensy reaches TOUCHDOWN (and >= 2 s
    after contact), else 10 s after contact. It used to stop 2 s after contact
    even when TOUCHDOWN came later (4.3 s after a frozen-IMU abort), so the
    console event was lost and the twin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
2026-11-07 flight3d: FlightView.set_track() re-frames for a new or growing track
    Refreshes the wide-view centre and distance and the zoom limit from the
    track's bounds; follow_end puts the playhead at the newest sample.
2026-11-07 Dashboard: HIL bench window (closed-loop bench sim, live plots + 3D)
    tools/sim/hil_panel.py, opened from a new "HIL bench..." top-bar button as
    its own Toplevel. Ports (auto/COM/socket), every Scenario field, a Live legs
    checkbox that asks you to type LEGS, Connect/Prepare/Arm/Launch/Abort/
    Reboot/Stop and 3D view. Status line: link Hz, phase, Teensy state, max gap
    and stale. The runner runs in a spawn-safe multiprocessing.Process. Live
    plots at ~10 Hz (altitude truth vs KF, vertical speed, tilt, gimbal, state
    strip). An open 3D view is re-pointed at the growing flight ~4x a second.
    When the flight ends, the result loads into the dashboard, the twin flies
    in a thread, and the comparison tabl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
2026-11-07 HIL README: live closed-loop bench sim section; test_hil g++ fallback
    README: setup, what's real vs simulated, safety (landing gate never driven,
    legs opt-in, reboot boots the chute OPEN), the bench sequence in the
    dashboard and with live_run.py, how to read the twin table, the PC test,
    and the protocol/file map from the hand-off notes.
    test_hil.py: MSYS2 ucrt64 g++ when present, else g++ on PATH (Linux
    fallback); host binary gets .exe only on Windows.
